adamino-moss/adams-buck/-VERSION 2 FILES-/BOM.xlsx

Index | Manufacturer Part Number | Attrition % | Requested Quantity 1 | Pack Quantity 1 | Pack Type 1 | Digi-Key Part Number 1 | Unit Price 1 | Extended Price 1 | Minimum Order Quantity 1 | Product Notes
1 | US2AA |  | 1 | 1 | Cut Tape (CT) | 488-US2AACT-ND | 0.61000 | $0.61 | 1
2 | UCC5304DWVR |  | 1 | 1 | Cut Tape (CT) | 296-UCC5304DWVRCT-ND | 3.45000 | $3.45 | 1
3 | TMV 0512SHI |  | 1 | 1 | Tube | TMV0512SHI-ND | 14.29000 | $14.29 | 1
4 | TAJR105K025RNJ |  | 4 | 4 | Cut Tape (CT) | 478-8928-1-ND | 0.88000 | $3.52 | 1
5 | SS310 |  | 1 | 1 | Cut Tape (CT) | 1801-SS310CT-ND | 0.68000 | $0.68 | 1
6 | RNCP0805FTD1K00 |  | 10 | 10 | Cut Tape (CT) | RNCP0805FTD1K00CT-ND | 0.02400 | $0.24 | 1
7 | RMCF0805JT300R |  | 1 | 1 | Cut Tape (CT) | 738-RMCF0805JT300RCT-ND | 0.16000 | $0.16 | 1
8 | RMCF0805FT120R |  | 2 | 2 | Cut Tape (CT) | 738-RMCF0805FT120RCT-ND | 0.16000 | $0.32 | 1
9 | RCP1206W50R0JTP |  | 1 | 1 | Cut Tape (CT) | 541-RCP1206W50R0JTPCT-ND | 2.32000 | $2.32 | 1
10 | RC1206FR-0751RL |  | 1 | 1 | Cut Tape (CT) | 311-51.0FRCT-ND | 0.16000 | $0.16 | 1
11 | RC0805FR-0712RL |  | 1 | 1 | Cut Tape (CT) | 311-12.0CRCT-ND | 0.16000 | $0.16 | 1
12 | RC0805FR-072KL |  | 2 | 2 | Cut Tape (CT) | 311-2.00KCRCT-ND | 0.16000 | $0.32 | 1
13 | LTST-C190GKT |  | 5 | 5 | Cut Tape (CT) | 160-1183-1-ND | 0.23000 | $1.15 | 1
14 | LM358AP |  | 1 | 1 | Tube | 296-9554-5-ND | 0.44000 | $0.44 | 1
15 | LAUNCHXL-F28379D |  | 1 | 1 | Bulk | 296-46713-ND | 71.12000 | $71.12 | 1
16 | IRF540NPBF |  | 1 | 1 | Tube | IRF540NPBF-ND | 1.91000 | $1.91 | 1
17 | GRM21BR61E106KA73L |  | 1 | 1 | Cut Tape (CT) | 490-5523-1-ND | 0.33000 | $0.33 | 1
18 | GRM21BC72A105KE01L |  | 1 | 1 | Cut Tape (CT) | 490-14464-1-ND | 0.52000 | $0.52 | 1
19 | F951C106MPAAQ2 |  | 1 | 1 | Cut Tape (CT) | 478-8456-1-ND | 1.20000 | $1.20 | 1
20 | CRCW08057R50FKEAHP |  | 1 | 1 | Cut Tape (CT) | 541-7.50TCT-ND | 0.31000 | $0.31 | 1
21 | CRCW080540K0FKEA |  | 4 | 4 | Cut Tape (CT) | 541-CRCW080540K0FKEACT-ND | 0.19000 | $0.76 | 1
22 | C0805C224K5RACTU |  | 1 | 1 | Cut Tape (CT) | 399-C0805C224K5RACTUCT-ND | 0.15000 | $0.15 | 1
23 | C0805C125K4PACTU |  | 1 | 1 | Cut Tape (CT) | 399-13163-1-ND | 0.56000 | $0.56 | 1
24 | C0603C330J5GACTU |  | 1 | 1 | Cut Tape (CT) | 399-C0603C330J5GACTUCT-ND | 0.17000 | $0.17 | 1
25 | BU-P72930-2 |  | 5 | 5 | Bag | 314-1554-ND | 4.82000 | $24.10 | 1
26 | 1140-123K-RC |  | 2 | 2 | Bulk | 1140-123K-RC-ND | 18.12000 | $36.24 | 1
27 | 100ZLH470MEFC16X31.5 |  | 1 | 1 | Bulk | 1189-1712-ND | 2.67000 | $2.67 | 1
28 | 860020772007 |  | 1 | 1 | Cut Tape (CT) | 732-8968-1-ND | 0.17000 | $0.17 | 1
29 | 577202B00000G |  | 1 | 1 | Bag | HS107-ND | 1.36000 | $1.36 | 1
30 | 4880G |  | 1 | 1 | Bulk | HS417-ND | 5.56000 | $5.56 | 1 | No Backorders Allowed.
31 | 61202021621 |  | 4 | 4 | Tray | 732-2096-ND | 1.31000 | $5.24 | 1
32 | 971100154 |  | 4 | 4 | Bulk | 732-12917-ND | 0.92000 | $3.68 | 1
33 | 4707 |  | 4 | 4 | Bulk | 36-4707-ND | 0.26000 | $1.04 | 1
