adamino-moss/adams-buck/BU-P72930-2/3D/BU-P72930-2.step

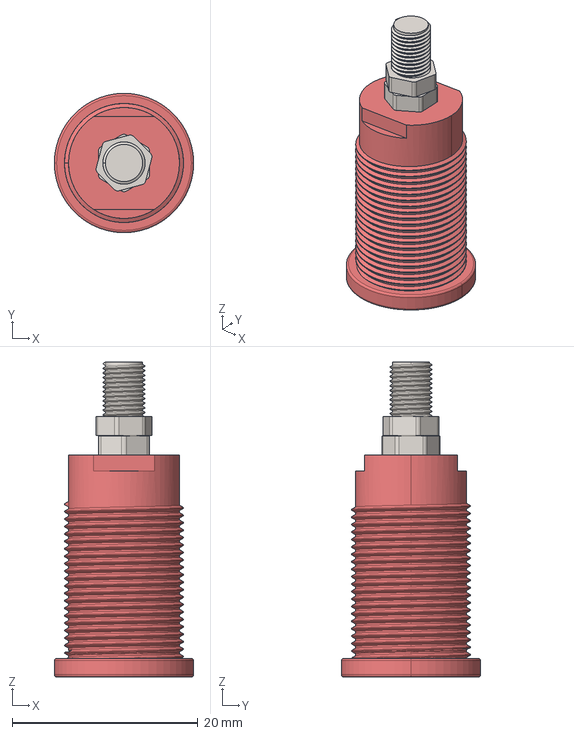
[picture p1: CAD file, 2025-02-25]
BU-P72930-2/3D/BU-P72930-2.step
15.0 x 15.0 x 33.9 mm
