adamino-moss/adams-buck/(list of files, cad)

Other CAD files:
BU-P72930-2/3D/BU-P72930-2.stp
