adamino-moss/adams-buck/-VERSION 2 FILES-/Buck_Converter_v2/Buck_Converter.kicad_pcb

## KiCad design -VERSION 2 FILES-/Buck_Converter_v2/Buck_Converter.kicad_pcb (2025-03-03)

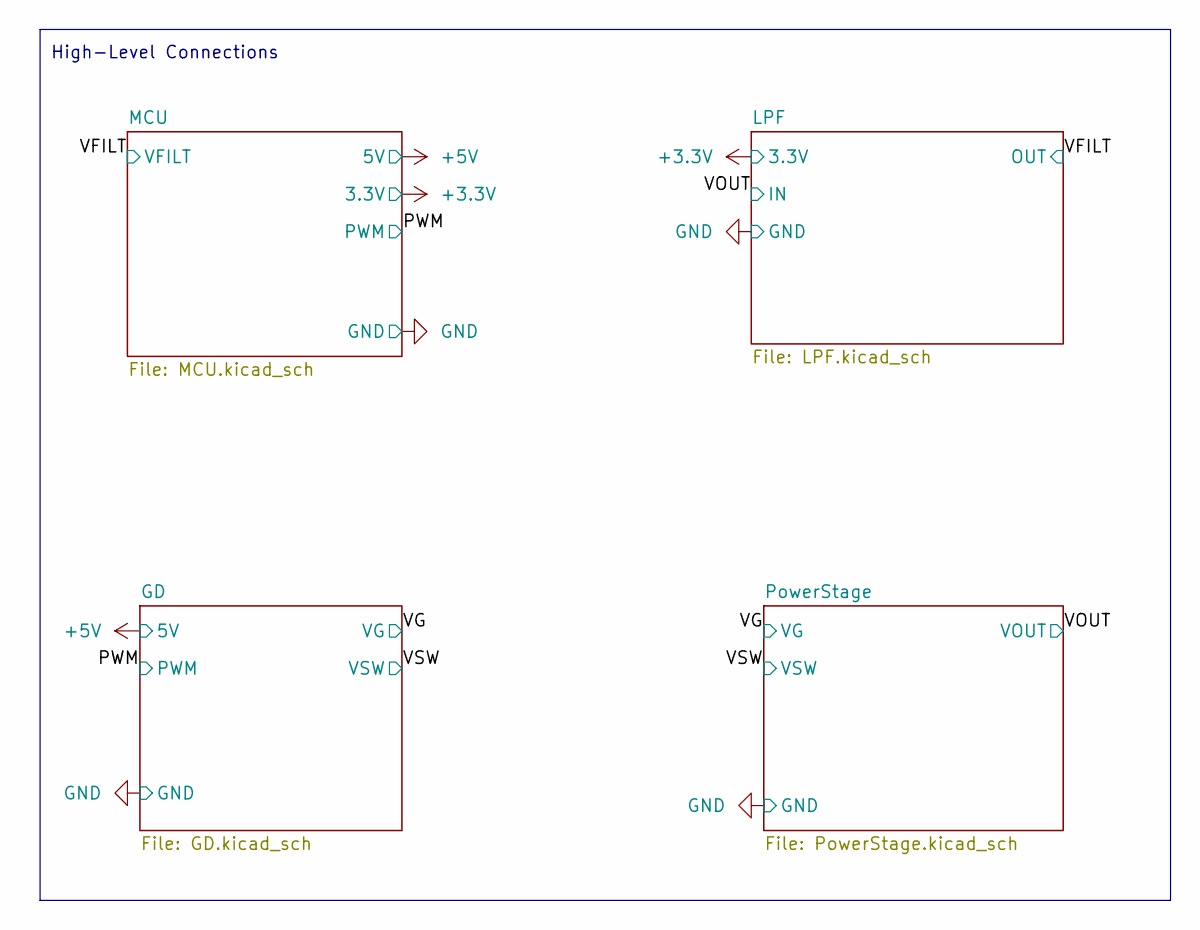
[picture p2: schematic Buck_Converter.kicad_sch, Buck Converter]

Notes on the sheet:
High-Level Connections

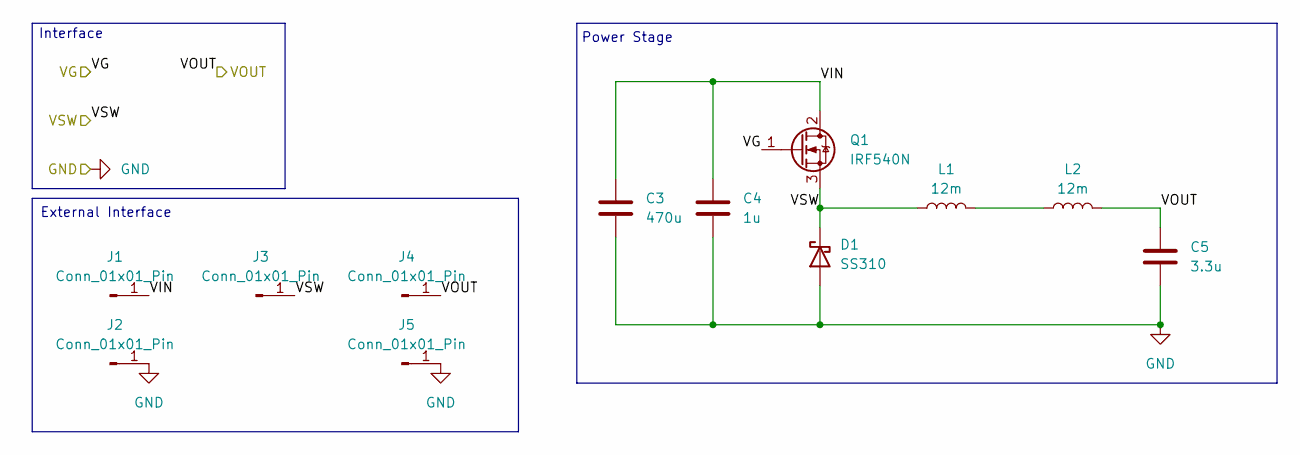
[picture p3: schematic PowerStage.kicad_sch, Buck Converter]

Parts:
C3: 470u; CP_Radial_D18.0mm_P7.50mm; Part Number 100ZLH470MEFC16X31.5
C4: 1u; C_0805_2012Metric_Pad1.18x1.45mm_HandSolder; Part Number GRM21BC72A105KE01L
C5: 3.3u; CP_Radial_D5.0mm_P2.00mm; Part Number 860020772007
D1: SS310; D_SMA_Handsoldering; Part Number SS310
J1, J2, J3, J4, J5: Conn_01x01_Pin; Banana_Jack_1Pin; Part Number BU-P72930-2
L1, L2: 12m; L_Radial_D40.6mm_P27.18mm_Vishay_IHB-4; Part Number 1140-123K-RC
Q1: IRF540N; TO-220-3_Vertical; Part Number IRF540NPBF

Connections:
/PowerStage/VIN: C3.1, C4.1, J1.1, Q1.2 (D)
/VG: Q1.1 (G); also elsewhere on the board
/VOUT: C5.1, J4.1, L2.2; also elsewhere on the board
/VSW: D1.1 (K), J3.1, L1.1, Q1.3 (S); also elsewhere on the board
GND: C3.2, C4.2, C5.2, D1.2 (A), J2.1, J5.1; also elsewhere on the board
unnamed: L1.2, L2.1

Notes on the sheet:
Interface
External Interface
Power Stage

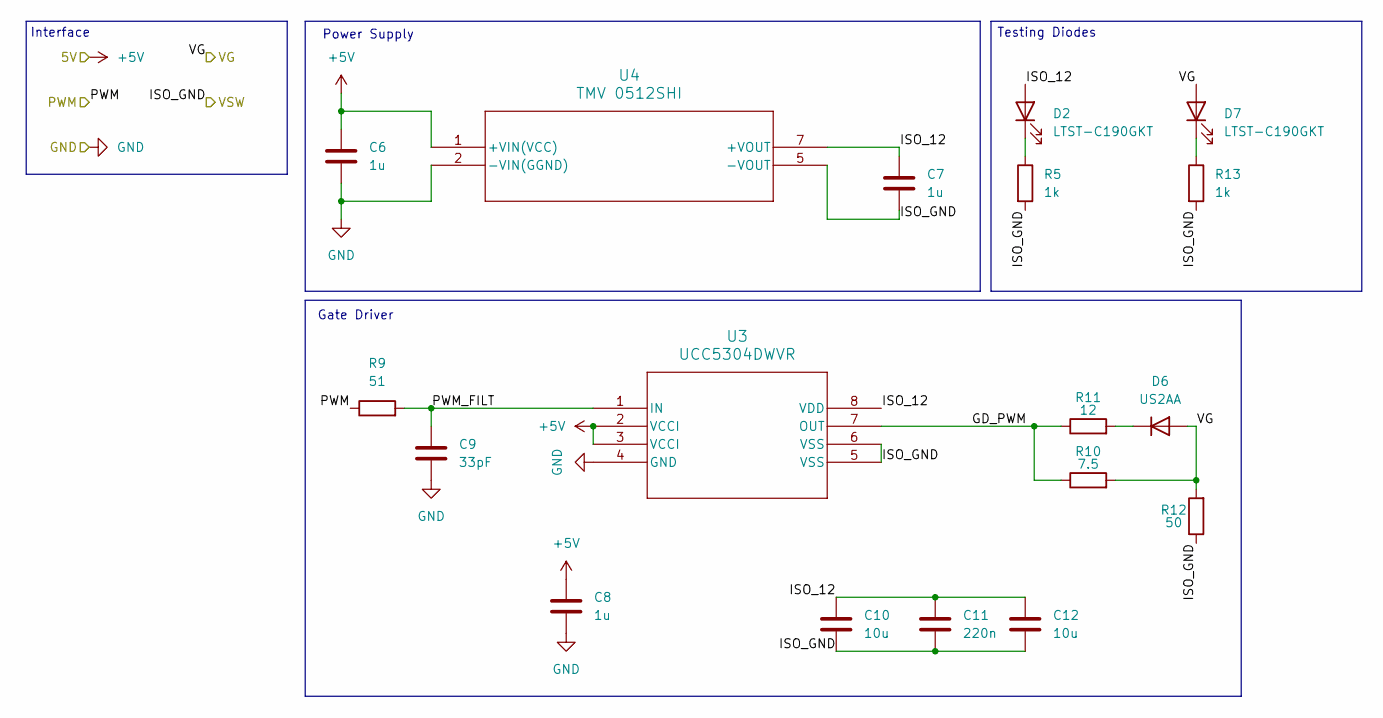
[picture p4: schematic GD.kicad_sch, Buck Converter]

Parts:
C6, C7, C8: 1u; C_0805_2012Metric_Pad1.18x1.45mm_HandSolder; Part Number TAJR105K025RNJ
C9: 33pF; C_0603_1608Metric_Pad1.08x0.95mm_HandSolder; Part Number C0603C330J5GACTU
C10: 10u; C_0805_2012Metric_Pad1.18x1.45mm_HandSolder; Part Number F951C106MPAAQ2
C11: 220n; C_0805_2012Metric_Pad1.18x1.45mm_HandSolder; Part Number C0805C224K5RACTU
C12: 10u; C_0805_2012Metric_Pad1.18x1.45mm_HandSolder; Part Number GRM21BR61E106KA73L
D2, D7: LTST-C190GKT; LED_0603_1608Metric_Pad1.05x0.95mm_HandSolder; Part Number LTST-C190GKT
D6: US2AA; D_SMA; Part Number US2AA
R5, R13: 1k; R_0805_2012Metric_Pad1.20x1.40mm_HandSolder; Part Number RNCP0805FTD1K00
R9: 51; R_1206_3216Metric_Pad1.30x1.75mm_HandSolder; Part Number RC1206FR-0751RL
R10: 7.5; R_0805_2012Metric_Pad1.20x1.40mm_HandSolder; Part Number CRCW08057R50FKEAHP
R11: 12; R_0805_2012Metric_Pad1.20x1.40mm_HandSolder; Part Number RC0805FR-0712RL
R12: 50; R_1206_3216Metric_Pad1.30x1.75mm_HandSolder; Part Number RCP1206W50R0JTP
U3: UCC5304DWVR; SOIC8_DWV_TEX; Part Number UCC5304DWVR
U4: TMV 0512SHI; TMV-HI_SINGLE_TRP; Part Number TMV 0512SHI

Connections:
+5V: C6.1, C8.1, U3.2 (VCCI), U3.3 (VCCI), U4.1 (+VIN(VCC)); also elsewhere on the board
/GD/GD_PWM: R10.1, R11.1, U3.7 (OUT)
/GD/ISO_12: C7.1, C10.1, C11.1, C12.1, D2.2 (A), U3.8 (VDD), U4.7 (+VOUT)
/GD/PWM_FILT: C9.1, R9.2, U3.1 (IN)
/PWM: R9.1; also elsewhere on the board
/VG: D6.2 (A), D7.2 (A), R10.2, R12.2; also elsewhere on the board
/VSW: C7.2, C10.2, C11.2, C12.2, R5.2, R12.1, R13.2, U3.5 (VSS), U3.6 (VSS), U4.5 (-VOUT); also elsewhere on the board
GND: C6.2, C8.2, C9.2, U3.4 (GND), U4.2 (-VIN(GGND)); also elsewhere on the board
unnamed: D2.1 (K), R5.1
unnamed: D6.1 (K), R11.2
unnamed: D7.1 (K), R13.1

Notes on the sheet:
Testing Diodes
Power Supply
Gate Driver
Interface

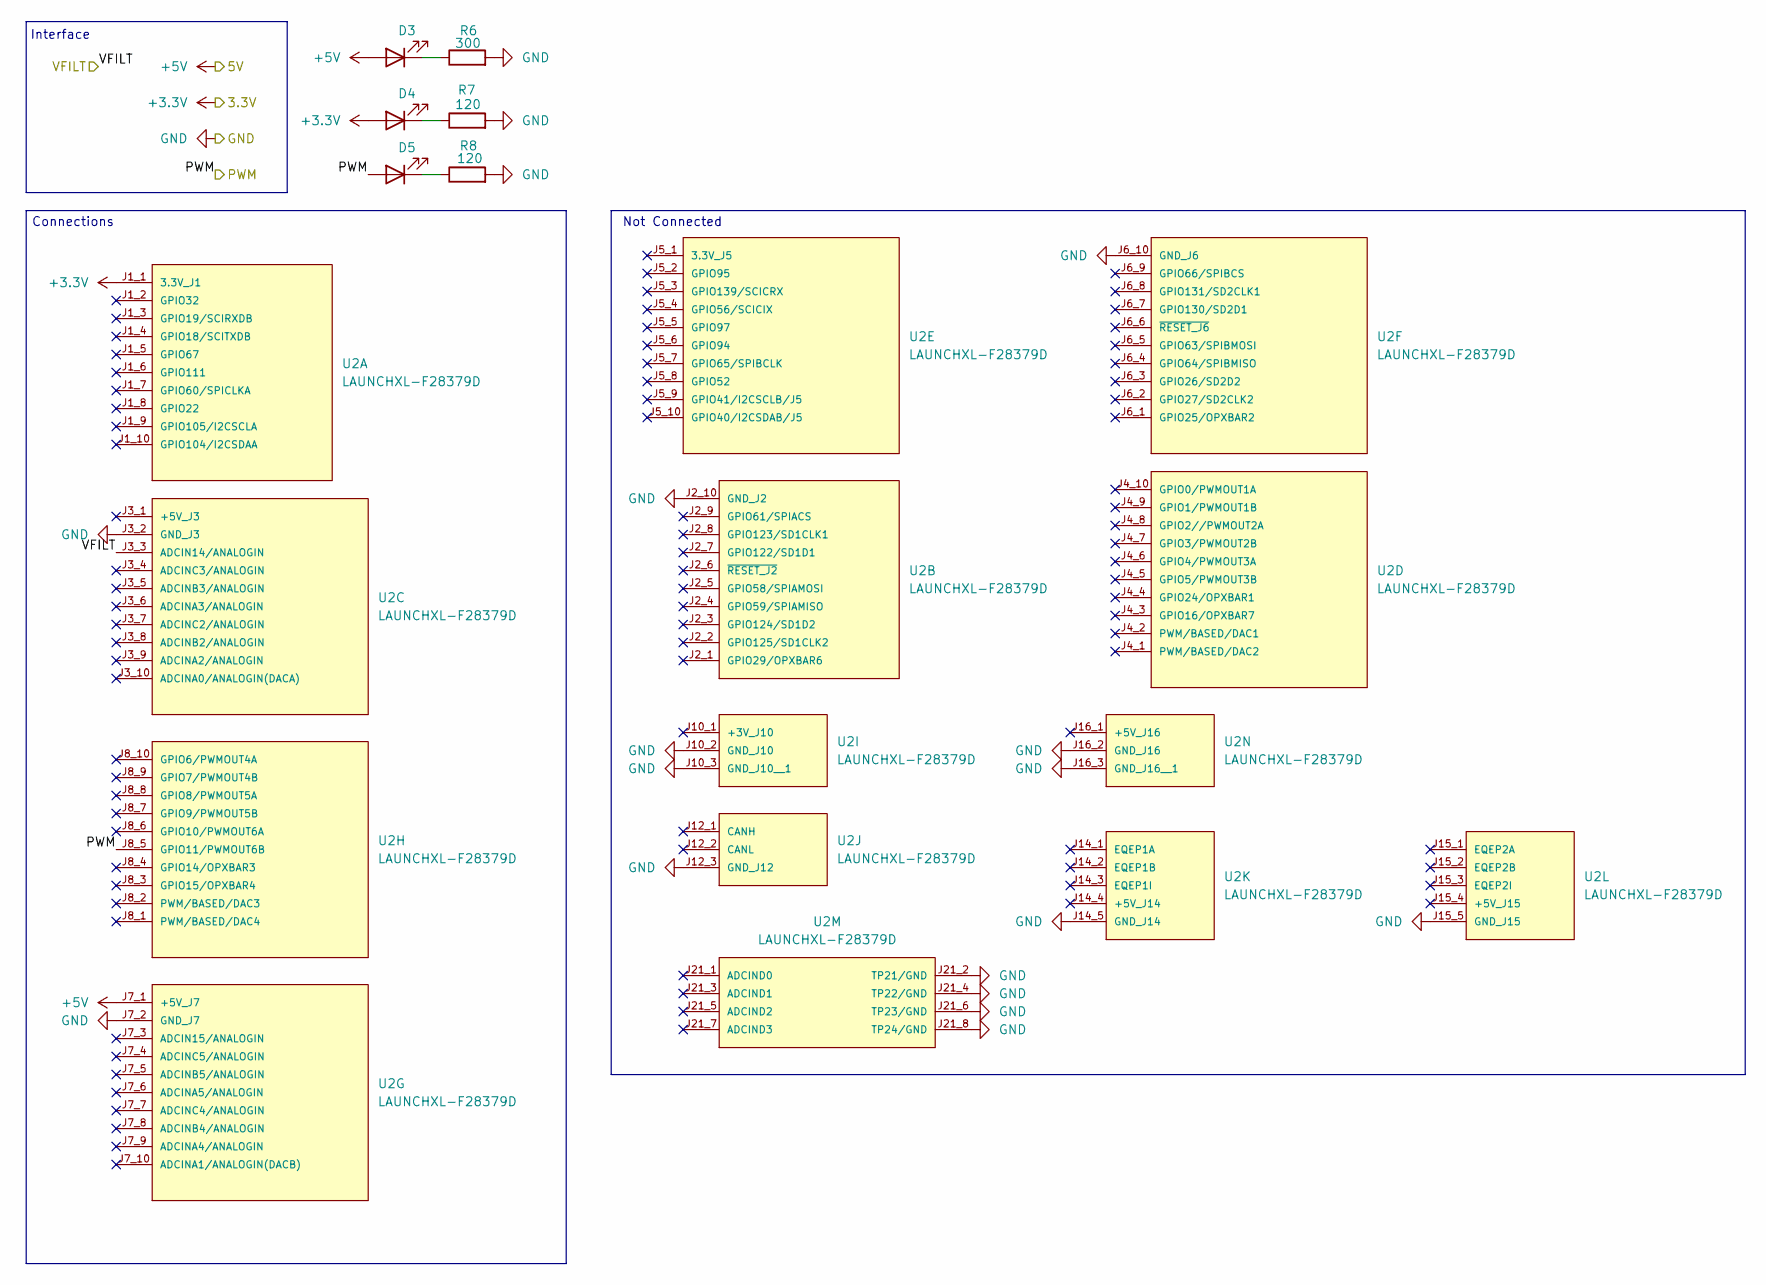
[picture p5: schematic MCU.kicad_sch, Buck Converter]

Parts:
D3, D4, D5: LTST-C190GKT; LED_0603_1608Metric_Pad1.05x0.95mm_HandSolder; Part Number LTST-C190GKT
R6: 300; R_0805_2012Metric_Pad1.20x1.40mm_HandSolder; Part Number RMCF0805JT300R
R7, R8: 120; R_0805_2012Metric_Pad1.20x1.40mm_HandSolder; Part Number RMCF0805FT120R
U2: LAUNCHXL-F28379D; MOD_LAUNCHXL-F28379D; PARTREV 2.0

Connections:
+3.3V: D4.2 (A), U2.J1_1 (3.3V_J1); also elsewhere on the board
+5V: D3.2 (A), U2.J7_1 (+5V_J7); also elsewhere on the board
/PWM: D5.2 (A), U2.J8_5 (GPIO11/PWMOUT6B); also elsewhere on the board
/VFILT: U2.J3_3 (ADCIN14/ANALOGIN); also elsewhere on the board
GND: R6.2, R7.2, R8.2, U2.J2_10 (GND_J2), U2.J3_2 (GND_J3), U2.J6_10 (GND_J6), U2.J7_2 (GND_J7), U2.J10_2 (GND_J10), U2.J10_3 (GND_J10__1), U2.J12_3 (GND_J12), U2.J14_5 (GND_J14), U2.J15_5 (GND_J15), U2.J16_2 (GND_J16), U2.J16_3 (GND_J16__1), U2.J21_2 (TP21/GND), U2.J21_4 (TP22/GND), U2.J21_6 (TP23/GND), U2.J21_8 (TP24/GND); also elsewhere on the board
unnamed: D3.1 (K), R6.1
unnamed: D4.1 (K), R7.1
unnamed: D5.1 (K), R8.1

Notes on the sheet:
Connections
Interface
Not Connected

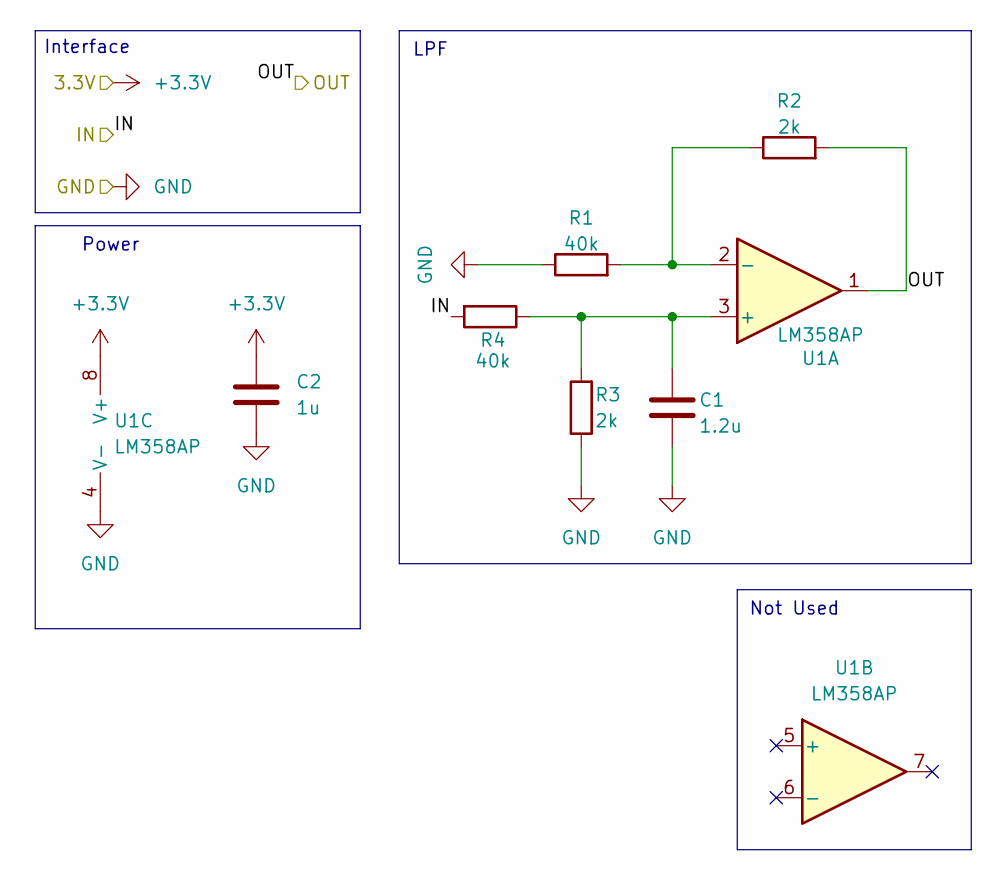
[picture p6: schematic LPF.kicad_sch, Buck Converter]

Parts:
C1: 1.2u; C_0805_2012Metric_Pad1.18x1.45mm_HandSolder; Part Number C0805C125K4PACTU
C2: 1u; C_0805_2012Metric_Pad1.18x1.45mm_HandSolder; Part Number TAJR105K025RNJ
R1, R4: 40k; R_0805_2012Metric_Pad1.20x1.40mm_HandSolder; Part Number CRCW080540K0FKEA
R2, R3: 2k; R_0805_2012Metric_Pad1.20x1.40mm_HandSolder; Part Number RC0805FR-072KL
U1: LM358AP; DIP794W45P254L959H508Q8; Part Number LM358AP

Connections:
+3.3V: C2.1, U1.8 (V+); also elsewhere on the board
/VFILT: R2.2, U1.1; also elsewhere on the board
/VOUT: R4.2; also elsewhere on the board
GND: C1.2, C2.2, R1.1, R3.1, U1.4 (V-); also elsewhere on the board
unnamed: C1.1, R3.2, R4.1, U1.3 (+)
unnamed: R1.2, R2.1, U1.2 (-)

Notes on the sheet:
LPF
Power
Not Used
Interface

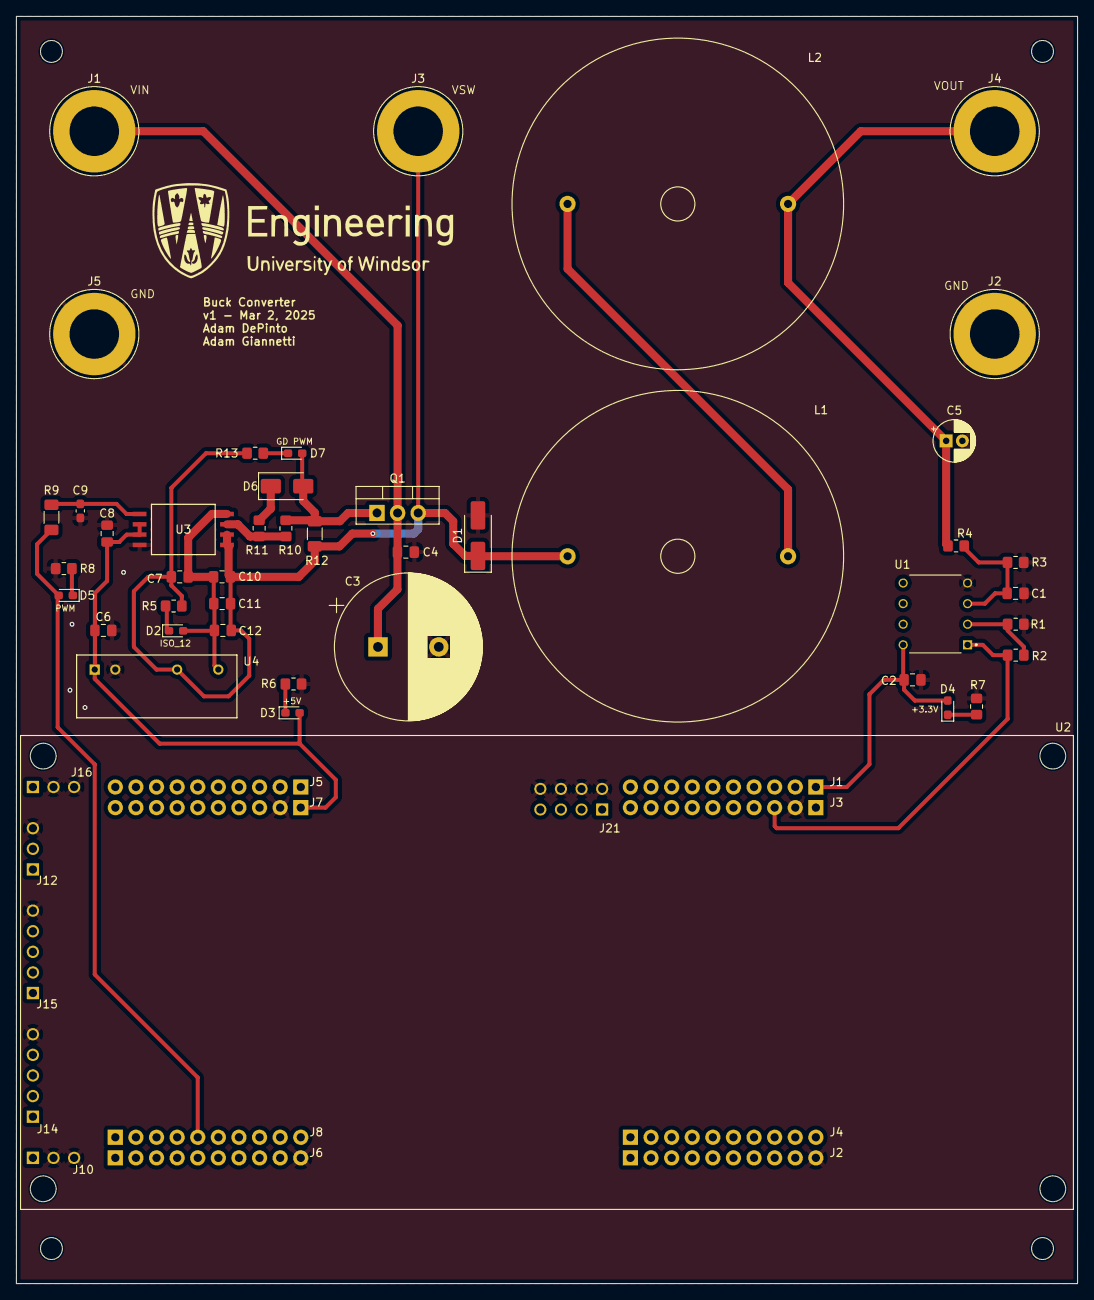
[picture p7: board Buck_Converter.kicad_pcb from above]

Board: 2 copper layers, 130.8 x 156.2 mm, 44 parts (0 on the bottom side), 21 nets.
