adamino-moss/adams-buck/(commit log)

2025-02-25 Add files via upload
    Main KiCAD filts
    [Buck_Converter.kicad_pcb, Buck_Converter.kicad_sch, GD.kicad_sch, LPF.kicad_sch, MCU.kicad_sch, PowerStage.kicad_sch]
2025-02-25 Add files via upload
    3D model for banana connectors
    [BU-P72930-2.step, BU-P72930-2.stp]
2025-02-25 Add files via upload
    3D model and symbol for the power supply
2025-02-25 Add files via upload
    3D model and symbol for the gate driver
2025-02-25 Add files via upload
    Footprint for the University logo
2025-02-25 Add files via upload
    Added the BOM
    [Buck_Materials.csv]
2025-03-03 Add files via upload
    Revised Buck Converter schematic and PCB, BOM, and gerber files
    [BOM.xlsx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]
